Habraken/cariboulite/README.md

# CaribouLite
CaribouLite is an affordable, educational, open-source SDR evaluation platform and a HAT for the Raspberry-Pi family of boards (40-pin versions only). It is built for makers, hackers, and researchers and was designed to complement the current SDR (Software Defined Radio) eco-systems offering with a scalable, standalone dual-channel software-defined radio.

<table>
  <tr>
    <td>Open source hardware association certificate</td>
    <td>This project has been certified by OSHWA</td>
  </tr>
</table>

<table>
  <tr>
    <td>CaribouLite R2</td>
  </tr>
  <tr>
    <td>CaribouLite R2.5 SDR mounted on a RPI-Zero</td>
  </tr>
</table>

## NOTE: No Support for RPI-5
Due to the architectural changes in RPI5 - the new I/O controller called "RP1" chip, CaribouLite is not supported on RPI5. We assume that the reason is the removal of the SMI interface altogether from the external interfaces by Broadcomm's team.
So, if you intend to use CaribouLite on RPI5 please don't - it won't work. Why was the SMI interface deprecated by Broadcomm (either from its hardware or kernel SW support)? Most probably due to the same reason this interface was not documented in the first place - no interest in supporting a high-speed external interface within the 40-pin connector.

A Pi 5 transport redesign was proposed historically, but no working implementation is established here. Display/camera connectors are separate from the 40-pin GPIO header. Feasibility and scope are tracked as [DOC-10](ROADMAP.md#documentation-validation-backlog).

## Development fork status — 4 October 2026

The accepted NBFM TX/RX, mono WBFM RX and FM refactoring work is now on
`main`. Further receive modes are developed on `dev-additional-modes`, starting
with CW listening, then AM and SSB; these modes remain planned. See the
[development overview](docs/wiki/Home.md), [FM plan](docs/demodulator-architecture-research.md)
and [interface reference](docs/audio-dsp-interfaces.md).

# Getting Started & Installation

For this development checkout, also read [additional notes](ADDITIONAL-README.md),
the [documentation audit](docs/documentation-audit-2026-09-16.md), and the
[roadmap](ROADMAP.md). The historical installation recipe has not been freshly
validated on every listed Pi/OS combination.
Use the following steps to install the CaribouLite on your choice of RPI board
1. Mount the CaribouLite on a **un-powered** RPI device using the 40-pin header.
2. Power the RPI device, wait for it to finish boot sequence.
3. Clone this repository into a local directory of your choise (in this case `~/projects`)
```
mkdir ~/projects
cd ~/projects
git clone https://github.com/cariboulabs/cariboulite
cd cariboulite
```
4. Use the following setup command (**note: don't `sudo` it**):
    ```
    ./install.sh
    ```

The setup script **requires internet connection** and it follows the following automatic steps:
1. **Dependencies** installation (apt)
2. **Soapy API tools installation** (SoapySDR and SoapyRemote) - only if they are not currently present in the system. Installation from code.
3. **Internal dependencies installation**
   1. Utilities and tools
   2. IIR DSP library
   3. SMI stream device module (kernel object) blob generation
4. **Main software** and SoapyAPI compilation and installation
5. **Raspberry PI configuration** verification. The installer checks boot settings in `/boot/firmware/config.txt` when present, otherwise `/boot/config.txt`; it does not edit these boot settings. It does write module-loading, blacklist, module-option and udev files through the driver installer.

Note: the user will be requested to enter their password during the installation process.

## Installation Troubleshooting
1. **Boot interfaces:** disable the primary SPI and ARM I2C settings used by
   conflicting overlays; enable `i2c_vc` and `spi1-3cs` as described in the
   [additional notes](ADDITIONAL-README.md). The installer checks for text
   presence and can warn even about explicit `off` values (DOC-01).
2. **Kernel headers:** the current module sources are in [driver](driver/README.md).
   Rebuild for the running kernel after kernel or driver changes. Kernel
   mainline inclusion is not an implemented installation mechanism (DOC-02).
3. **Access permissions:** the current `io_utils` build uses `rpi/rpi.c` and
   `spidev/spi.c`, not the commented-out PIGPIO sources. GPIO initialization
   selects `/dev/gpiomem`; SPI uses `/dev/spidev*`, and SMI uses `/dev/smi`.
   Check the applicable device permissions and process limits; blanket claims
   that every application must run with sudo are outdated. The current broad
   udev rules and unprivileged behavior need validation (DOC-01).

To compile the API library and SoapySDR API from code please click [here](/software/libcariboulite/README.md)

# SMI Interface

Unlike many other HAT projects, CaribouLite utilizes the **SMI** (Secondary Memory Interface) used on the supported pre-Pi-5 Raspberry Pi models. This interface is not thoroughly documented by both Raspberry-Pi documentation and Broadcomm's reference manuals. An amazing work done by [Lean2](https://iosoft.blog/2020/07/16/raspberry-pi-smi/) (code in [git repo](https://github.com/jbentham/rpi)) in hacking this interface has contributed to CaribouLite's technical feasibility. A deeper overview of the interface is provided by G.J. Van Loo, 2017 `Secondary_Memory_Interface.pdf` (the referenced local PDF is missing; recovery is tracked as DOC-09). The SMI interface allows exchanging up to ~500 Mbit/s (depending on the FPGA, data-bus width, etc.) between the RPI and the HAT, and yet, the results vary between the different versions of RPI. The results further depend on the specific RPI version's DMA speeds.

The SMI interface can be accessed from the user space Linux applications as shown in [Lean2](https://iosoft.blog/2020/07/16/raspberry-pi-smi/), but Broadcomm also provided a neat minimal charachter device interface in the `/dev` directory using the `open`, `close`, `write`, `read`, and `ioctl` system calls. More on this interesting interface in the [designated readme file](software/libcariboulite/src/caribou_smi/README.md). This device driver needs to be loaded using `modprobe`.

More information on this interface can be found [here (HW side)](docs/smi/README.md) and [here (SW side)](software/libcariboulite/src/caribou_smi/README.md).

<table>
  <tr>
    <td>Top View</td>
  </tr>
  <tr>
    <td>Cariboulite /w RPI Zero, two channels occupied</td>
  </tr>
</table>

# Hardware Revisions
The board first prototyping (**Red**) revision (REV1; source assets are missing from this checkout, see DOC-09) has been produced and tested to meet our vision on the board's capabilities. This revision was used to test its RF parts, the digital parts, and to develop its firmware and software support over the RPI.

<table>
  <tr>
    <td>CaribouLite R1</td>
    <td>CaribouLite Connectors</td>
  </tr>
  <tr>
    <td>CaribouLite Rev1 - the prototype version</td>
    <td>CaribouLite Rev2.5 - Production Revision</td>
  </tr>
</table>

The second revision ([REV2](hardware/rev2)) - **White** - was then designed to further refine the design as described below:
1. Image rejection filtering improvement - U10 and U12 (HPF & LPF) - have been replaced by integrated LTCC filters by MiniCircuits with much better out-of-band rejection than the former ones.
2. Removing FPGA flash - redundant given the fact that the the RPI configures the FPGA in <1sec over SPI. Even if we have a whole library of custom made FPGA firmware files, switching between them is as simple and fast as a single linux command.
3. Board layout improvements and overlays (silkscreen) beautification (including logo).
4. A single system level 3.3V power (while the FPGA still receives 2.5V and 1.2V for its core). A linear regulator (rather than a switching DC-DC) was used to reduce conducted (power and ground) noise levels.
5. Top and bottom EMI sheilding option - the EMI/RFI shield design models are provided in the historical 3D directory (missing from this checkout; see DOC-09)
6. More detailed changes in the [schematics](hardware/rev2/schematics/CaribouLite.PDF).

In summary, in CaribouLite-Rev2.5 PCB design has been thoroughly re-thought to meet its educational needs with performance in mind. The RF path has been annotated with icons to ease the orientation in the schematics sheets, friendly silk writing was added describing system's components by their functionality rather than logical descriptors, and more.

<table>
  <tr>
    <td>Top View</td>
  </tr>
  <tr>
    <td>Top View</td>
  </tr>
  <tr>
    <td>Top and Bottom views of CaribouLite <b>Rev2.4</b> (pre-production)</td>
  </tr>
</table>

<table>
  <tr>
    <td>Top View</td>
    <td>Top View</td>
  </tr>
  <tr>
    <td>Top View</td>
  <td>Top View</td>
  </tr>
  <tr>
    <td>Top and Bottom views of CaribouLite <b>Rev2.5</b></td>
    <td>Top and Bottom views of CaribouLite <b>Rev2.5</b> with EMI/RFI shields</td>
  </tr>
</table>

# Specifications

<B>RF Channels:</B>
- Sub-1GHz: 389.5-510 MHz / 779-1020 MHz
- Wide tuning channel: 30 MHz - 6 GHz (excluding 2398.5-2400 MHz and 2483.5-2485 MHz)

<table>
  <tr>
    <td>spectra</td>
  </tr>
  <tr>
    <td style="text-align:center">Applicable spectra, S1G - sub-1GHz, WB - Wide tuning channel</td>
  </tr>
</table>
<B>Note</B>:
The gaps are defined by the design constraints of the system and may not exist in real-life hardware. Actual modem synthesizer outputs test show wider margins at room temperature than those written in the datatsheet, but, as noted by Microchip, performance may suffer.

<B>FPGA specifications:</B>
- 160 LABs / CLBs
- 1280 Logic Elements / Cells
- 65536 Total RAM bits
- 67 I/Os, Temp: -40-100 degC

<B>Applicable RPI models</B>: RPI_1(B+/A+), RPI_2B, RPI_Zero(Zero/W/WH), RPI_3(B/A+/B+), RPI_4B

Parameter                  |  Sub-1GHz                    | Wide Tuning Channel
---------------------------|------------------------------|------------------------------------------------------------------
Frequency tuner range      | 389.5-510 MHz / 779-1020 MHz | 30 MHz - 6 GHz (excluding 2398.5-2400 MHz and 2483.5-2485 MHz)
Sample rate (ADC / DAC)    | 4 MSPS                       | 4 MSPS
Analog bandwidth (Rx / Tx) | 2.5 MHz                      | 2.5 MHz
Max Transmit power         | 14 dBm                       | >10 dBm @ 30-2400 MHz, >5 dBm @ 2400-6000 MHz
Receive noise figure       | <5 dB                      | <6 dB @ 30-3500 MHz, <8 dB @ 3500-6000 MHz

<B>Note</B>:
(1) A dated, evidence-based comparison with other SDR devices remains [DOC-09](ROADMAP.md#documentation-validation-backlog).
(2) Some of the above specifications are simulated rather than tested
(3) Analog bandwidth controlled by the modem
(4) The ISM version of the board doesn't contain the wide-range of frequencies (30-6000 MHz) and contains the native capabilities of the Modem IC.

# Disclaimer
CaribouLite is a test equipment for RF systems. You are responsible for using your CaribouLite legally.

Definitions: THE SUBJECT CONTENT: all files, software, instructions, information, ideas and knowledge located in this git repository.

No Warranty: THE SUBJECT CONTENTS ARE PROVIDED "AS IS" WITHOUT ANY WARRANTY OF ANY KIND, EITHER EXPRESSED, IMPLIED, OR STATUTORY, INCLUDING, BUT NOT LIMITED TO, ANY WARRANTY THAT THE SUBJECT CONTENTS WILL CONFORM TO SPECIFICATIONS, ANY IMPLIED WARRANTIES OF MERCHANTABILITY, FITNESS FOR A PARTICULAR PURPOSE, OR FREEDOM FROM INFRINGEMENT, ANY WARRANTY THAT THE SUBJECT CONTENTS WILL BE ERROR FREE, OR ANY WARRANTY THAT DOCUMENTATION, IF PROVIDED, WILL CONFORM TO THE SUBJECT CONTENTS. FURTHER, THE REPOSITORY OWNERS AND CONTRIBUTORS DISCLAIM ALL WARRANTIES AND LIABILITIES REGARDING THIRD-PARTY SOFTWARE, IF PRESENT IN THE ORIGINAL SOFTWARE, AND DISTRIBUTE IT "AS IS."

Waiver and Indemnity: RECIPIENT AGREES TO WAIVE ANY AND ALL CLAIMS AGAINST THE REPOSITORY OWNERS AND CONTRIBUTORS, THEIR CONTRACTORS AND SUBCONTRACTORS, AS WELL AS ANY PRIOR RECIPIENT. IF RECIPIENT'S USE OF THE SUBJECT CONTENTS RESULTS IN ANY LIABILITIES, DEMANDS, DAMAGES, EXPENSES OR LOSSES ARISING FROM SUCH USE, INCLUDING ANY DAMAGES FROM PRODUCTS BASED ON, OR RESULTING FROM, RECIPIENT'S USE OF THE SUBJECT CONTENTS, RECIPIENT SHALL INDEMNIFY AND HOLD HARMLESS THE REPOSITORY OWNERS AND CONTRIBUTORS, THEIR CONTRACTORS AND SUBCONTRACTORS, AS WELL AS ANY PRIOR RECIPIENT, TO THE EXTENT PERMITTED BY LAW.

# License
<br />This work is licensed under a <a rel="license" href="http://creativecommons.org/licenses/by-sa/4.0/">Creative Commons Attribution-ShareAlike 4.0 International License</a>.
