Habraken/cariboulite/software/README.md

# CaribouLite Software
Containing all the software side for:
- `libcariboulite`: SDR APIs library - including SoapySDR
- `devicetrees`: linux device-trees overlays sources and binaries
- `utils`: various utilities
- [../examples](../examples/README.md): C, C++ and Python examples.
- `gr-caribouLite`: GNU Radio receive source module; TX integration remains on the roadmap.

# License
<br />This work is licensed under a <a rel="license" href="http://creativecommons.org/licenses/by/4.0/">Creative Commons Attribution 4.0 International License</a>.
