Habraken/cariboulite/docs/wiki/Home.md

# CaribouLite development fork

This repository builds on the original **CaribouLabs CaribouLite** hardware,
software and FPGA project. Jan's development work focuses on practical RX/TX
operation, NBFM audio, better diagnostics, and more reliable sample streaming.

**The accepted NBFM TX/RX and mono WBFM RX work is now on
[`main`](https://github.com/Habraken/cariboulite/tree/main).**
The FM refactoring steps 1–4 were accepted and merged on 4 October 2026.
New receive-mode work starts on
[`dev-additional-modes`](https://github.com/Habraken/cariboulite/tree/dev-additional-modes),
with CW listening first, followed by AM and SSB. These additional modes are
planned, not selectable features. The original `dev` branch is retained.

## What has changed?

The original CaribouLabs project provides the foundation: board support, modem
and mixer control, FPGA interfaces, SMI transport and SDR APIs. This fork extends
that foundation and addresses defects found while developing and testing it.

| Area | Accepted work on `main` |
| --- | --- |
| NBFM transmit and receive | NBFM TX/RX, mono WBFM RX, and audio pipelines in the diagnostic application, including ALSA audio routing. |
| Interactive diagnostics | NBFM menu entries and a modem monitor with RX/TX controls, register displays and streaming instrumentation. |
| FPGA TX and diagnostics | Work on TX sample sequencing, stop/reset behavior, sample-gap control and an interface-loopback diagnostic, with a tested loopback image promoted into the repository. |
| Streaming reliability | Fixes for device ownership, partial writes, timeouts, cancellation and repeated RX/TX start/stop behavior. |
| API and resource handling | Corrections to C/C++ and Soapy streaming paths, buffer handling and SPI resource cleanup. |
| Kernel compatibility | Driver builds and recorded live checks on Raspberry Pi 4 with the 64-bit kernel `6.18.39+rpt-rpi-v8`; kernel API adaptations are included in `main`. |
| Build and installation | Firmware dependency/failure handling, standalone builds without SoapySDR, and driver installation restricted to the kernel used for the build. |
| Tests and documentation | Software regressions, FPGA simulations, recorded hardware observations, a documentation audit and a development roadmap. |

These are additions and corrections made during this fork's development;
they are not a claim that every listed feature was absent from upstream.

## What works today?

Jan has reported successful **NBFM TX and RX operation** on the development
setup, including audio checks. The current diagnostic menu includes:

- **11 — NBFM TX Tone**
- **12 — NBFM RX**
- **13 — NBFM modem Self-Test**
- **14 — Monitor Modem Status**, with TX/RX and interface-loopback controls

Menu 14 uses `radio_high`, the RF24/HiF mixer path, for TX and RX, with a default
frequency of 430.100 MHz and ALSA loopback audio. Pressing T
starts/toggles TX; it does not automatically select an internal test tone.
RX supports stopped-only NBFM/mono-WBFM mode selection, 1/2/4 MS/s rate
selection and separate RX/TX frequency controls. Mode, rate and frequency
changes are blocked while streaming, and loopback guards remain in place.
NBFM noise squelch and optional carrier squelch are available; WBFM supports
carrier squelch only. Audio device defaults remain configured in code, so these are
working development tools rather than a finished configurable transceiver UI.

The separate L interface-loopback diagnostic still uses its RF24 receive path.
FPGA interface loopback has simulation coverage and recorded hardware results.
It checks part of the digital sample path; it does not demonstrate an RF QSO.
Physical Soapy RX checks are recorded, while physical Soapy TX and complete
GNU Radio TX/RX workflows still need validation.

## Kernel compatibility

As of **16 September 2026**, Jan's development system runs the 64-bit Raspberry
Pi kernel **`6.18.39+rpt-rpi-v8`**. Driver builds, installation and live RX/TX
checks on this kernel are recorded in the
[review and validation log](https://github.com/Habraken/cariboulite/blob/main/docs/code-review-2026-09-12.md).
The `main` branch includes the kernel API adaptations needed by this setup.

This identifies the kernel actually used for development and testing. Other
kernel versions still need their own validation, and the SMI module must be
rebuilt against matching headers after a kernel update.

## Where to start

Use the [`main` source tree](https://github.com/Habraken/cariboulite/tree/main)
and read the [additional installation and usage notes](https://github.com/Habraken/cariboulite/blob/main/ADDITIONAL-README.md).
They explain the development menu and audio setup, and identify historical
instructions that still need fresh installation testing.

After building, launch the application from the repository root:

```sh
./build/cariboulite_test_app 2>debug.log
```

Menu option 3 programs `firmware/top.bin` relative to that directory. Keep the
application, library, kernel driver and FPGA image consistent with the setup
being tested; selecting a Git branch does not update already installed binaries
or the image running on the FPGA.

## What is next?

The [roadmap](https://github.com/Habraken/cariboulite/blob/main/ROADMAP.md) covers:

- Clearer hardware, streaming, DSP and application interfaces, with configurable settings and broader tests.
- Squelch and menu 15: a VHF/UHF transceiver, starting with NBFM and later adding SSB, AM, CW and PSK modes.
- FPGA antenna/PTT/external-PA sequencing, Pi Zero testing, Ethernet audio/PTT and GNU Radio integration.
- Re-creating the schematics and PCB as an editable KiCad project.
- Two practical milestones: a first on-air NBFM QSO and a QO-100 QSO using SSB, CW or PSK.

These are planned milestones, not completed capabilities.

## Evidence and current limits

This overview was updated on **4 October 2026**. The eight-step audio/DSP
extraction and FM refactoring steps 1–4 are complete and physically accepted.
DSP modes own separate state, share allocation-free audio primitives, and use
a neutral `audio_demod` worker boundary with legacy API compatibility.
Software comparisons preserve exact PCM, raw taps and processing progress at
2/4 MS/s under strict and production compiler flags.

Intermittent distortion on 96.2 MHz was also observed through SDR++; much
stronger adjacent signals were reported at 95.9/96.5 MHz. A stronger station
produced clean audio, including through the Jabra speaker. The RF cause remains
unconfirmed; no refactoring regression was established.
Successful operation on Jan's setup does not establish support for every Pi,
OS, sample rate, RF path or external application. Fresh installation recipes,
RF performance and several integration paths remain under validation.

For the details behind the overview:

- [FM architecture, completed steps and acceptance](https://github.com/Habraken/cariboulite/blob/main/docs/demodulator-architecture-research.md)
- [Audio/DSP interfaces](https://github.com/Habraken/cariboulite/blob/main/docs/audio-dsp-interfaces.md)
- [Step-4 physical evidence](https://github.com/Habraken/cariboulite/blob/main/docs/baselines/20261003-fm-step4/README.md)

- [Code review and fix status](https://github.com/Habraken/cariboulite/blob/main/docs/code-review-2026-09-12.md)
- [FPGA study, hardware observations and promotion record](https://github.com/Habraken/cariboulite/blob/main/docs/fpga-gap-study-2026-09-13.md)
- [FPGA simulation checks and coverage limits](https://github.com/Habraken/cariboulite/blob/main/firmware/tests/README.md)
- [Documentation audit](https://github.com/Habraken/cariboulite/blob/main/docs/documentation-audit-2026-09-16.md)

Feedback is most useful when it includes the source revision, Pi model,
OS/kernel, FPGA image, menu/API path and steps needed to reproduce the result.
