Habraken/cariboulite/docs/README.md

# Documentation

- [Additional installation and usage notes](../ADDITIONAL-README.md)
- [Development roadmap and unresolved documentation tasks](../ROADMAP.md)
- [README validation report](documentation-audit-2026-09-16.md)
- [FM architecture and accepted refactoring steps](demodulator-architecture-research.md)
- [Menu 14 NBFM RX chain and sensitivity investigation](nbfm-rx-sensitivity-context.md)
- [Runtime profiling, stereo/RDS, DAB+ and adjustable CTCSS plan](runtime-profiling-and-decoder-plan.md)
- [NBFM complex channel filter](nbfm-channel-filter.md)
- [NBFM discriminator angle correction and CPU measurements](nbfm-discriminator-angle.md)
- [Scheduled menu 14 IQ recording](scheduled-menu14-iq-capture.md)
- [Audio/DSP interfaces](audio-dsp-interfaces.md)
- [Audio/DSP extension guide](audio-dsp-extension-guide.md)
- [Step-4 physical evidence](baselines/20261003-fm-step4/README.md)
- [Wiki overview source](wiki/Home.md)
- [SMI interface](smi/README.md)
- [EEPROM notes](flashing/README.md)
- [FPGA build and registers](../firmware/README.md)
- [Next FPGA test: LVDS Fmax before sequencer integration](lvds-fmax-next-test-2026-10-08.md)

# License
<br />This work is licensed under a <a rel="license" href="http://creativecommons.org/licenses/by-sa/4.0/">Creative Commons Attribution-ShareAlike 4.0 International License</a>.
