Habraken/cariboulite/manufacturing/rev2.8-full-eurocircuits/originals/assembly/dxf/top_emi_drawing.dxf

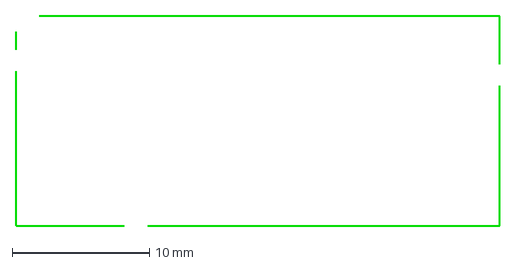
[picture p1: CAD file, 2026-09-13]
manufacturing/rev2.8-full-eurocircuits/originals/assembly/dxf/top_emi_drawing.dxf
35.2 x 15.2 mm
