Habraken/cariboulite/manufacturing/rev2.8-full-eurocircuits/originals/assembly/dxf/bottom_emi_drawing.dxf

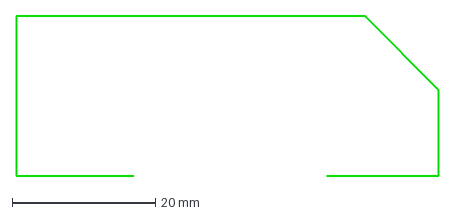
[picture p2: CAD file, 2026-09-13]
manufacturing/rev2.8-full-eurocircuits/originals/assembly/dxf/bottom_emi_drawing.dxf
59.0 x 22.2 mm
