Habraken/cariboulite/manufacturing/rev2.8-full-eurocircuits/source_manifest.md

# Source manifest

Repository commit: `d641a30b7f84c747008c77319ed4fb5d5dcd5397`

Hashes describe file contents at package generation; ISM variant files are inventoried but excluded.

| Source | Bytes | SHA-256 | Included |
|---|---:|---|---|
| `hardware/rev2/assembly/cariboulite_ad.PDF` | 429485 | `06ff852d6dadbaf617577aa71256e36cb22920a3ea1c571ff5a8441ec05f0fe2` | True |
| `hardware/rev2/assembly/dxf/bottom_emi_drawing.dxf` | 17808 | `cd04ee9178b3a7e0d64ddc9933e19037a1018f71df6390f471024ce862a8e80a` | True |
| `hardware/rev2/assembly/dxf/top_emi_drawing.dxf` | 17976 | `9215fcce824ddea93fde21a5f4bba452e5b53852239d8ca79c9adb6a8c05e9a9` | True |
| `hardware/rev2/assembly/full_bom/cariboulite_bom.xlsx` | 14724 | `2364750fdf24e97c25e7d7837e8c259b5d2b91cb83b7ce18e6b4b8066eb0e7d9` | True |
| `hardware/rev2/assembly/full_pnp/cariboulite_full_pnp.txt` | 30523 | `b10fa67b1226826b5731c93f0ef701d5a86c7cc6c1bcf2607dfc74e2f61d3e1f` | True |
| `hardware/rev2/assembly/ism_bom/cariboulite_ism_bom.xlsx` | 13326 | `b28f91d8c0919582bdae9644ad7b779ccfb9321003f2220761b5c6079d29e423` | False |
| `hardware/rev2/assembly/ism_pnp/cariboulite_ism_pnp.txt` | 17082 | `2d6e654cc9f0fbb4d88516151c0f8394cceb06e8b603fe7b4fdf8641f81086d6` | False |
| `hardware/rev2/pcb/gerber/cariboulite_r2.8.APR_LIB` | 37018 | `c65f41f1f5ff0ee96d975f81accb840b1d1dda0bbf8dcedf1998c72369a3c1a2` | True |
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
| `hardware/rev2/schematics/CaribouLite.PDF` | 2987905 | `57d33728403d0c8d10567be3fc9657d96f4d259fc30a5f506b1c498a8609c3e9` | True |
| `hardware/rev2/schematics/CaribouLite_ism.PDF` | 2990604 | `9f892cab7bac1e4079d90535e68fc2852dcef7bcdd9a2ec9649c453572b7960c` | False |
