Habraken/cariboulite/manufacturing/rev2.8-full-eurocircuits/originals/pcb/stack/cariboulite_r2.8.xls

Board Stack Report
Stack Up |  |  |  |  |  | Layer Stack
Layer | Board Layer Stack | Board Layer Stack | Board Layer Stack | Board Layer Stack | Board Layer Stack | Name | Material | Thickness | Constant
1 |  |  |  |  |  | Top Paste
2 |  |  |  |  |  | Top Overlay
3 |  |  |  |  |  | Top Solder | White | 1.00mil | 4
4 |  |  |  |  |  | Component Side | Copper | 1.38mil
5 |  |  |  |  |  | Dielectric 1 | PrePreg | 4.33mil | 4.3
6 |  |  |  |  |  | Layer 1 | Copper | 1.38mil
7 |  |  |  |  |  | Dielectric 7 | FR-4 | 47.24mil | 4.3
8 |  |  |  |  |  | Layer 2 | Copper | 1.38mil
9 |  |  |  |  |  | Dielectric 2 | PrePreg | 4.33mil | 4.3
10 |  |  |  |  |  | Solder Side | Copper | 1.38mil
11 |  |  |  |  |  | Bottom Solder | White | 1.00mil | 4
12 |  |  |  |  |  | Bottom Overlay
13 |  |  |  |  |  | Bottom Paste
 | Height : 63.42mil | Height : 63.42mil | Height : 63.42mil | Height : 63.42mil | Height : 63.42mil
