Habraken/cariboulite/manufacturing/rev2.8-full-eurocircuits/validation/drill-tools.csv

File | Tool | Copper span | Plating | Diameter inch | Diameter mm | Hits
cariboulite_r2.8.TXT | 2 | 1-4 | PTH | 0.008 | 0.2032 | 805
cariboulite_r2.8.TXT | 3 | 1-4 | PTH | 0.01811 | 0.459994 | 4
cariboulite_r2.8.TXT | 4 | 1-4 | PTH | 0.02362 | 0.599948 | 2
cariboulite_r2.8.TXT | 5 | 1-4 | PTH | 0.0315 | 0.8001 | 2
cariboulite_r2.8.TXT | 6 | 1-4 | PTH | 0.03543 | 0.899922 | 40
cariboulite_r2.8.TXT | 7 | 1-4 | NPTH | 0.10827 | 2.750058 | 3
cariboulite_r2.8.TX1 | 1 | 1-2 | PTH | 0.004 | 0.1016 | 661
cariboulite_r2.8.TX2 | 1 | 3-4 | PTH | 0.004 | 0.1016 | 736
