Habraken/cariboulite/manufacturing/rev2.8-full-eurocircuits/originals/schematics/CaribouLite.PDF

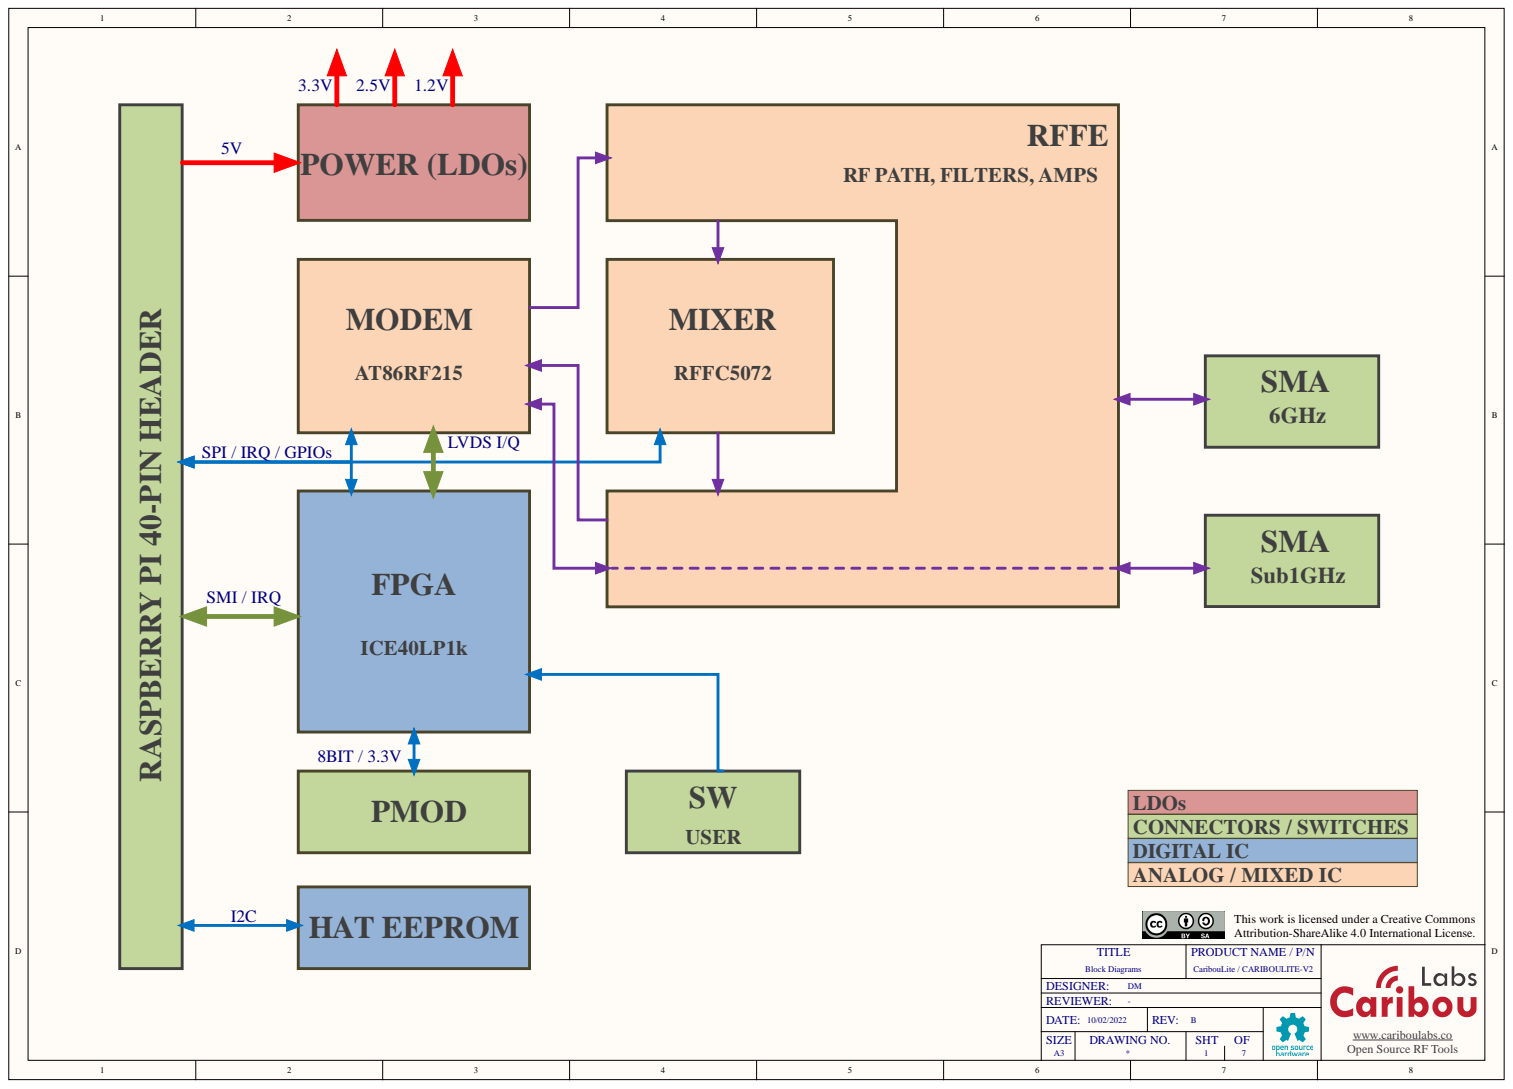
[picture p3: page 1]
SIZE; DRAWING NO.; CaribouLite / CARIBOULITE-V2; TITLE; PRODUCT NAME / P/N; Block Diagrams; POWER (LDOs); HAT EEPROM; 8BIT / 3.3V; LVDS I/Q; SMI / IRQ

RF PATH, FILTERS, AMPS

SPI / IRQ / GPIOs

LDOs
CONNECTORS / SWITCHES
DIGITAL IC
ANALOG / MIXED IC

This work is licensed under a Creative Commons
Attribution-ShareAlike 4.0 International License.

www.cariboulabs.co
Open Source RF Tools

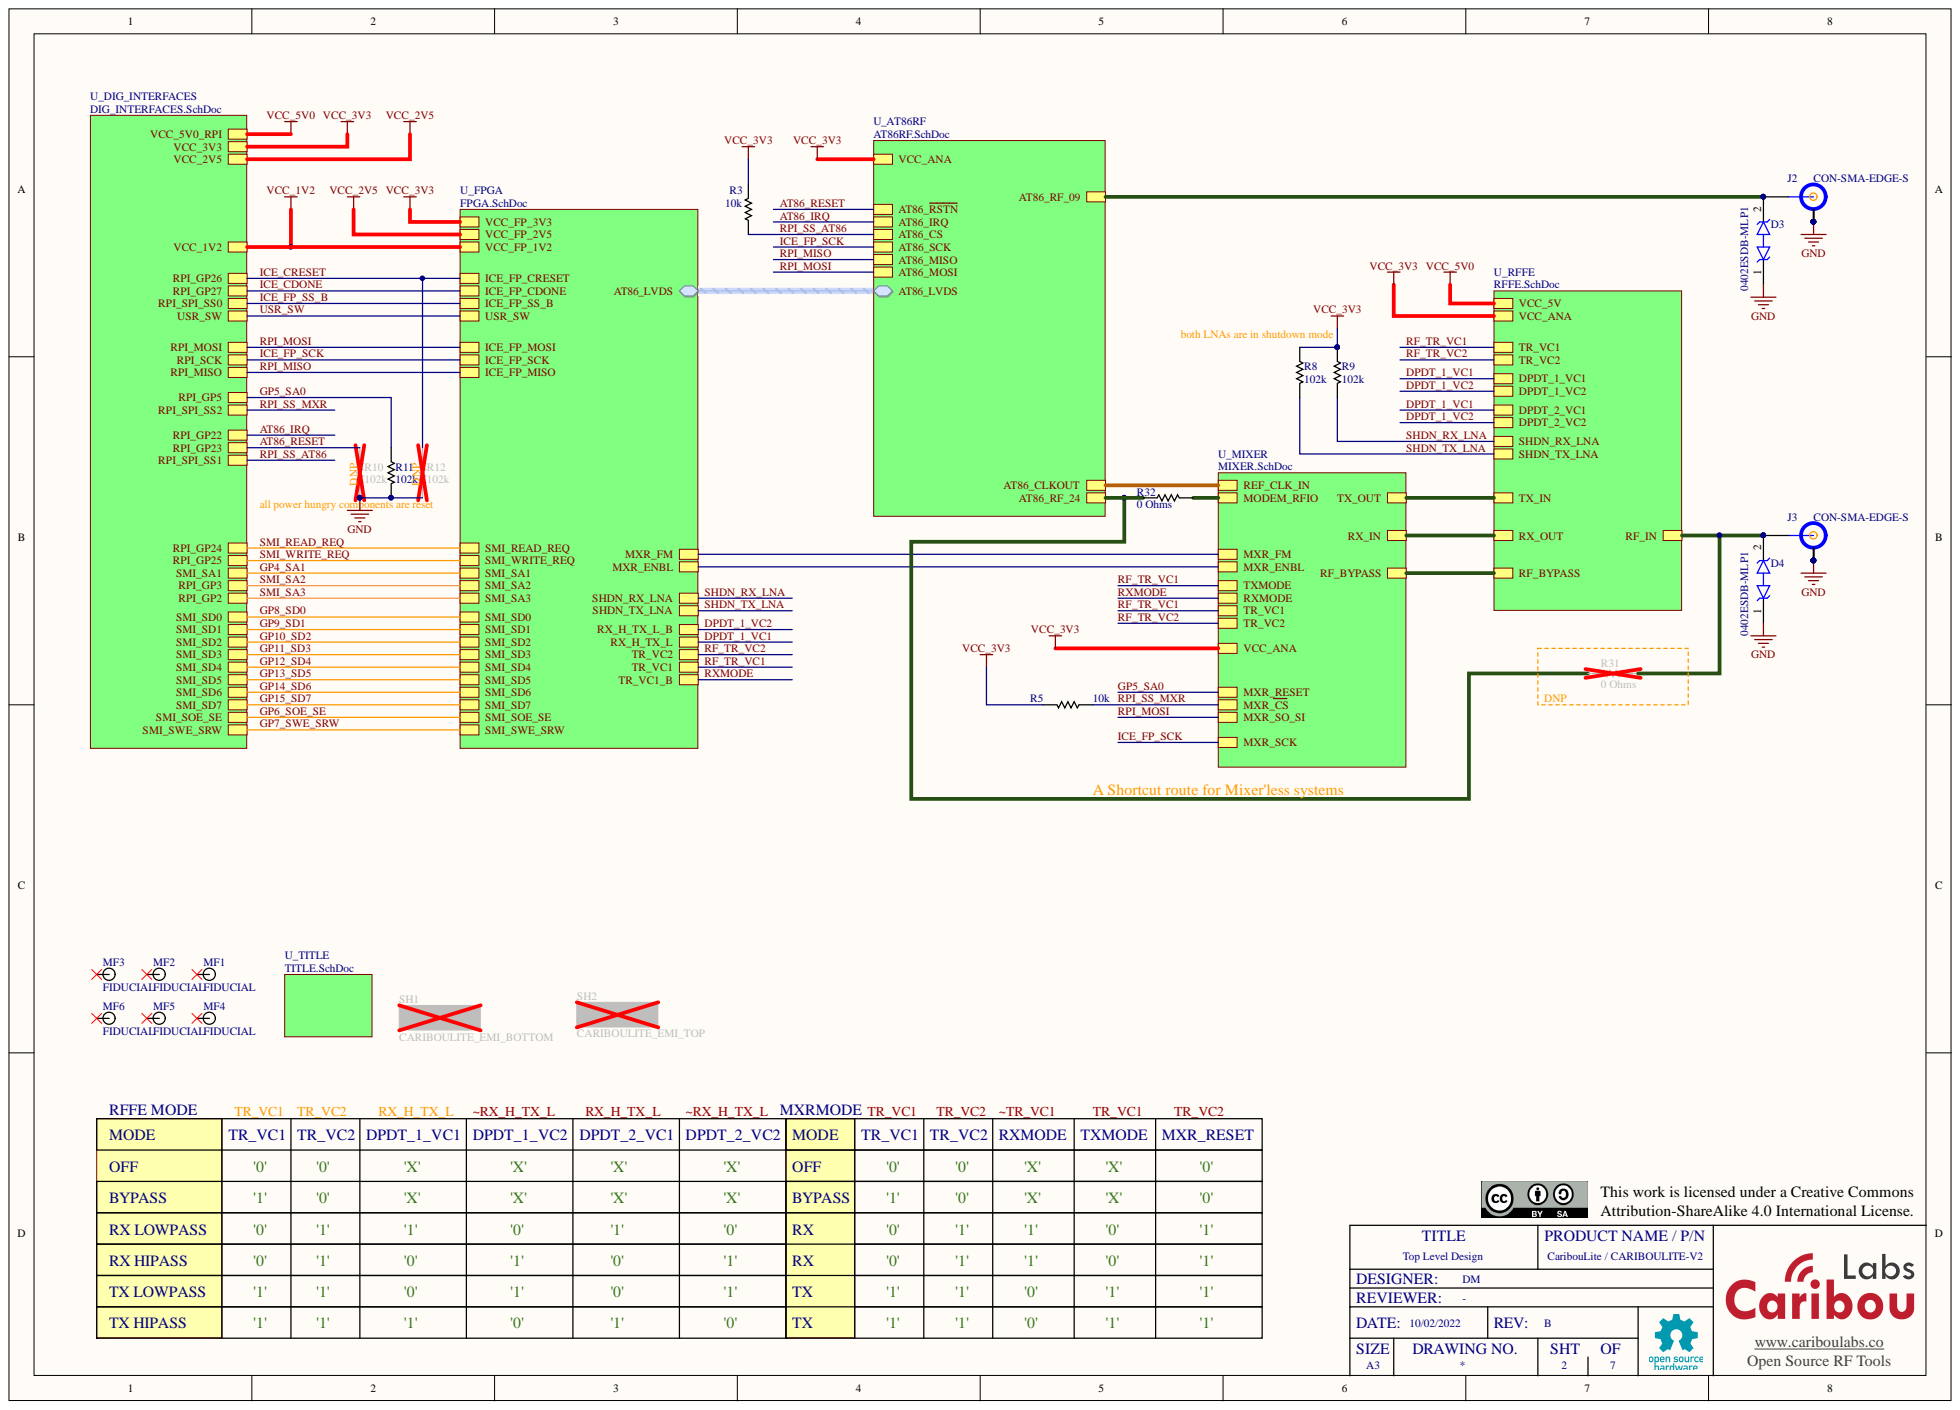
[picture p4: page 2]

ICE_CDONE
ICE_FP_SS_B
USR_SW

both LNAs are in shutdown mode

RPI_MISO

all power hungry components are reset

A Shortcut route for Mixer'less systems

MODE | TR_VC1 | TR_VC2 | DPDT_1_VC1 | DPDT_1_VC2 | DPDT_2_VC1 | DPDT_2_VC2 | MODE | TR_VC1 | TR_VC2 | RXMODE | TXMODE | MXR_RESET

OFF | '0' | '0' | 'X' | 'X' | 'X' | 'X' | OFF | '0' | '0' | 'X' | 'X' | '0'

This work is licensed under a Creative Commons
Attribution-ShareAlike 4.0 International License.

BYPASS | '1' | '0' | 'X' | 'X' | 'X' | 'X' | BYPASS | '1' | '0' | 'X' | 'X' | '0'

RX LOWPASS | '0' | '1' | '1' | '0' | '1' | '0' | RX | '0' | '1' | '1' | '0' | '1'

RX HIPASS | '0' | '1' | '0' | '1' | '0' | '1' | RX | '0' | '1' | '1' | '0' | '1'

TX LOWPASS | '1' | '1' | '0' | '1' | '0' | '1' | TX | '1' | '1' | '0' | '1' | '1'

TX HIPASS | '1' | '1' | '1' | '0' | '1' | '0' | TX | '1' | '1' | '0' | '1' | '1'

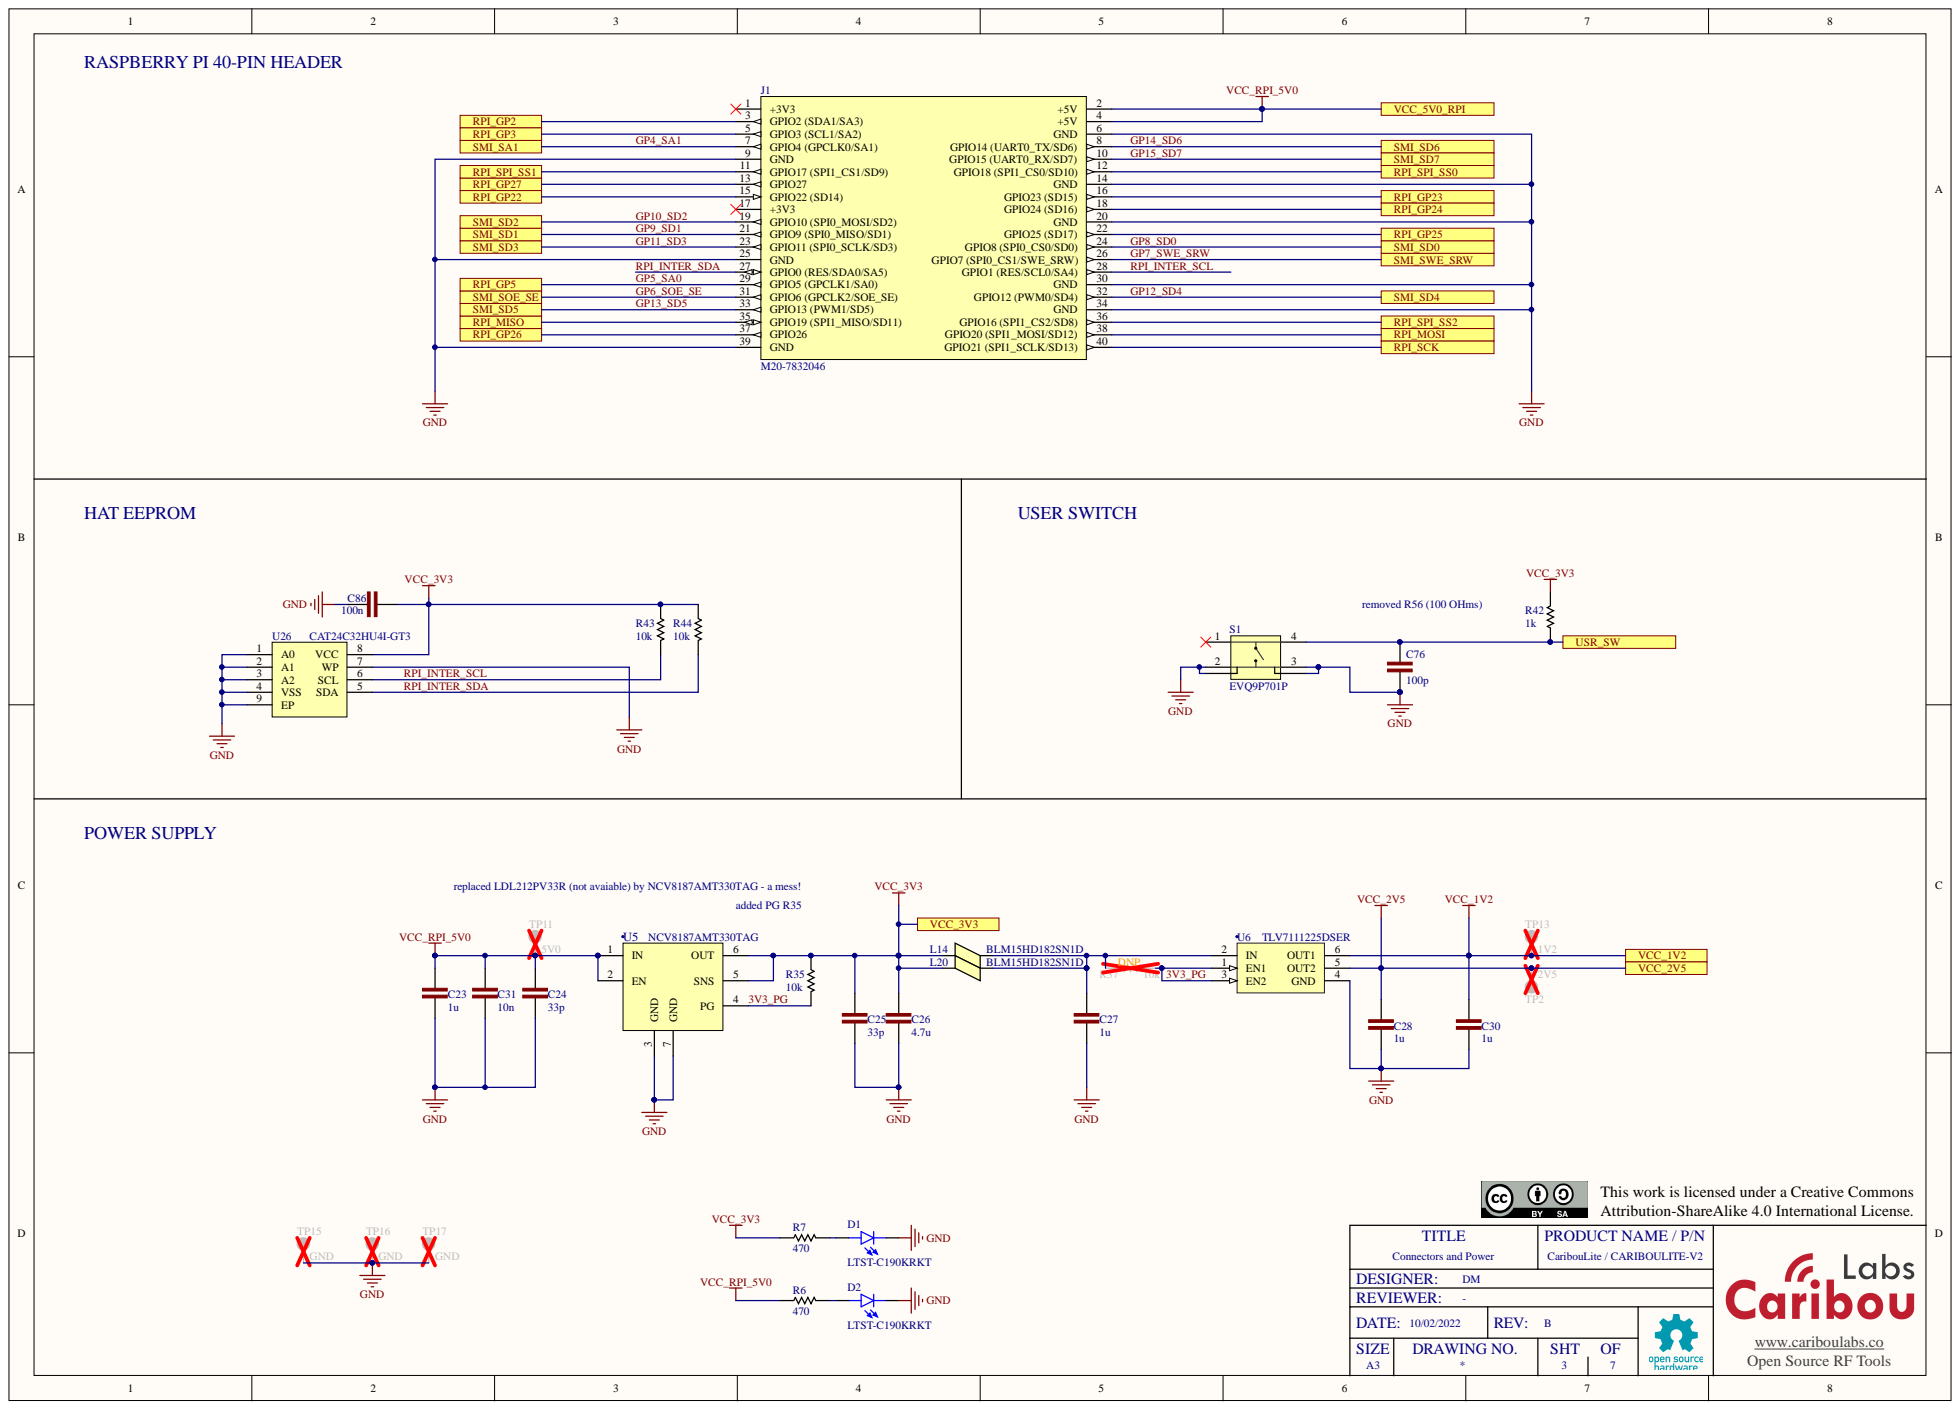
[picture p5: page 3]

RASPBERRY PI 40-PIN HEADER

VSS 4 | RPI_INTER_SDA
EP 9

replaced LDL212PV33R (not avaiable) by NCV8187AMT330TAG - a mess!

This work is licensed under a Creative Commons
Attribution-ShareAlike 4.0 International License.

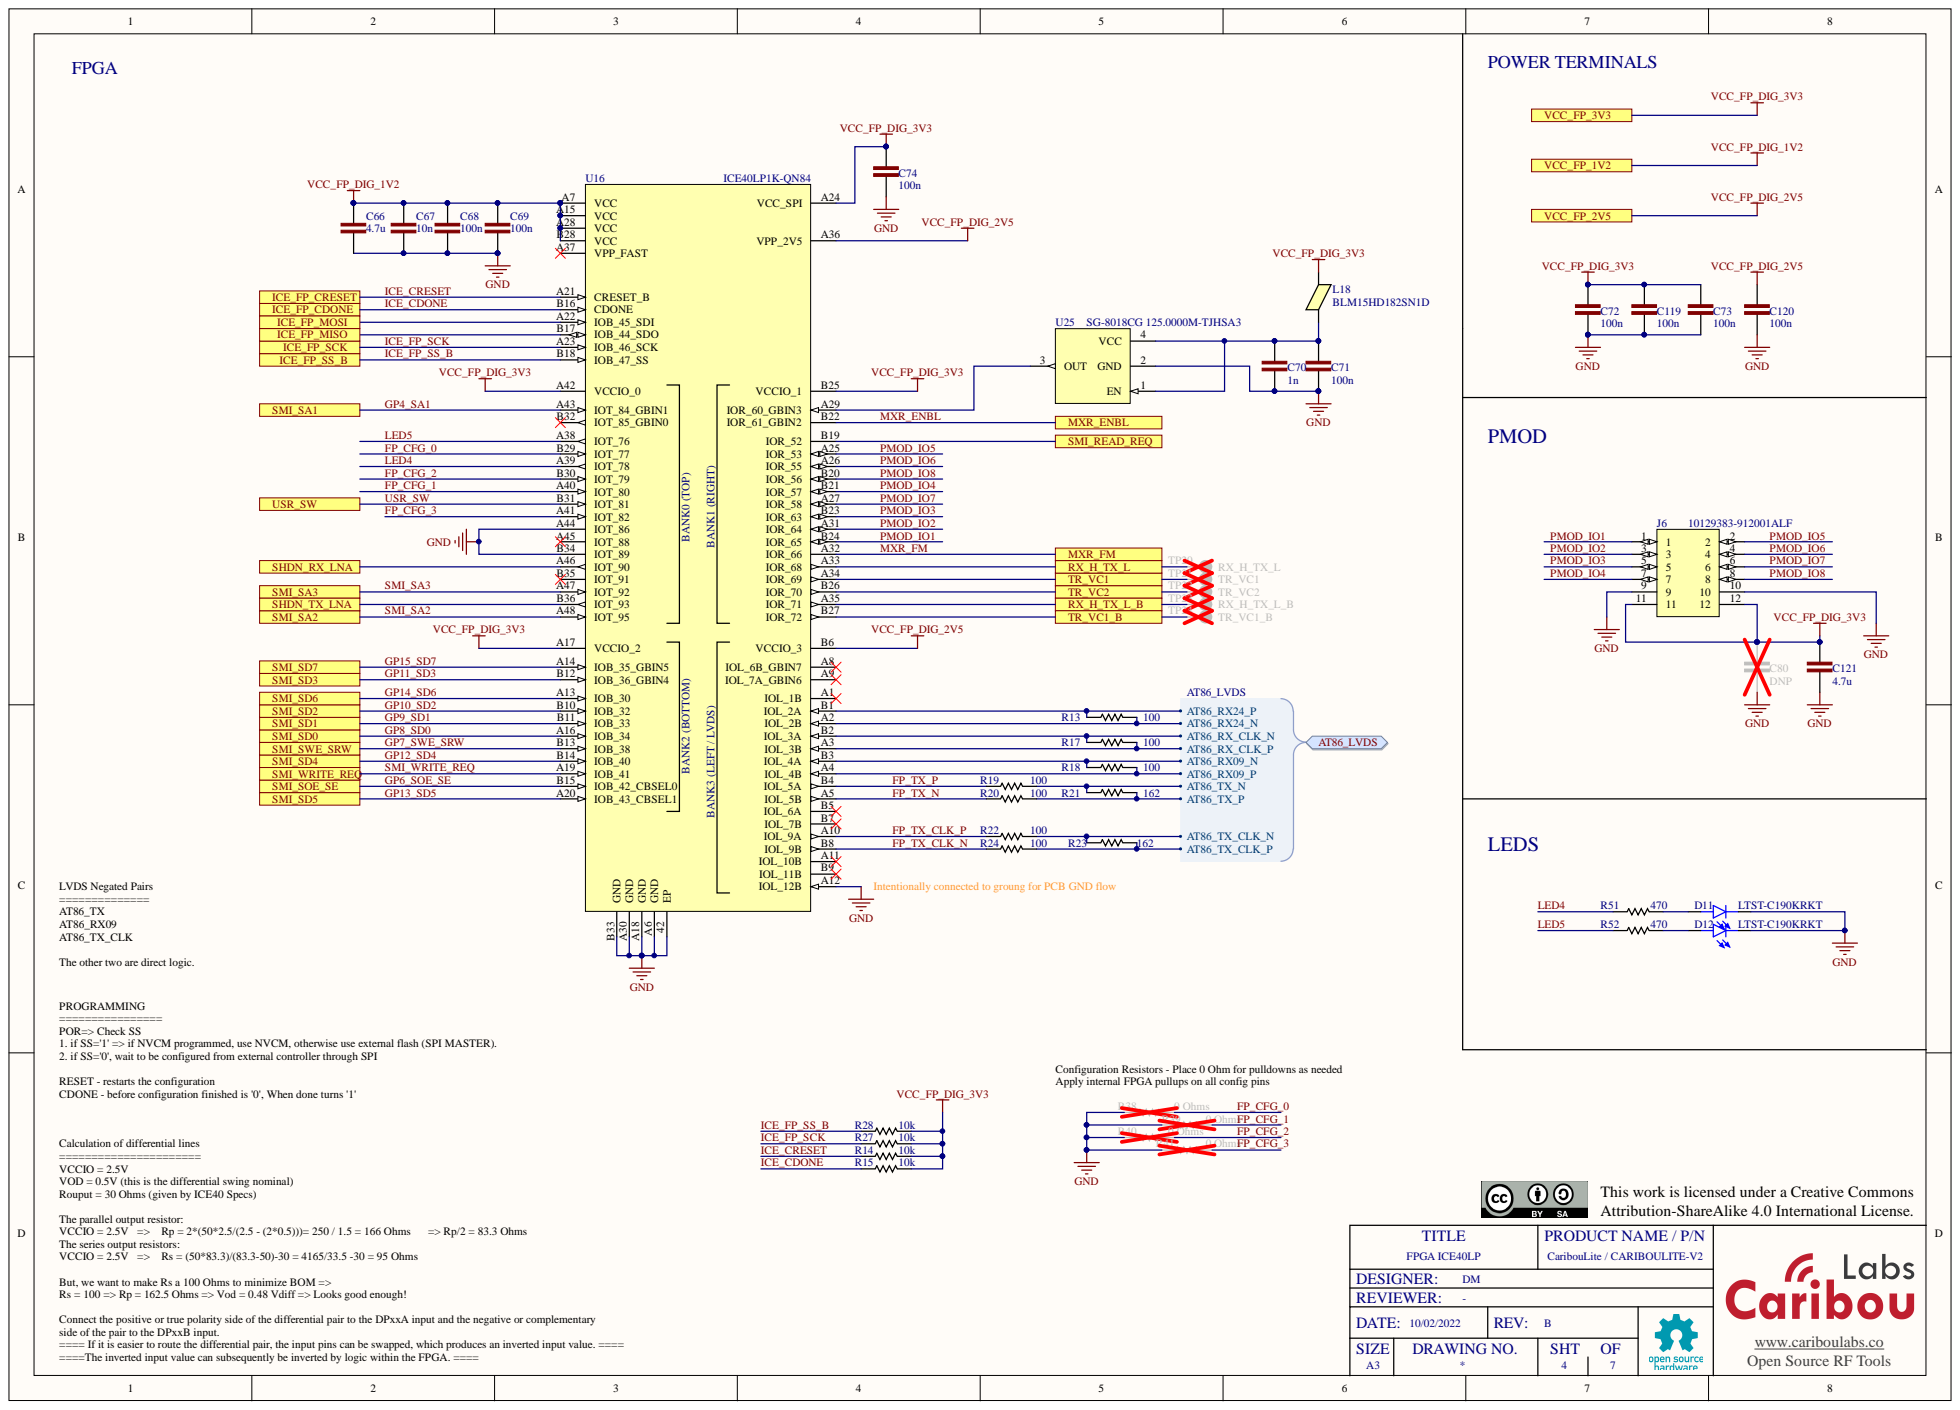
[picture p6: page 4]

Intentionally connected to groung for PCB GND flow

The other two are direct logic.

PROGRAMMING
POR=> Check SS
1. if SS='1' => if NVCM programmed, use NVCM, otherwise use external flash (SPI MASTER).
2. if SS='0', wait to be configured from external controller through SPI

Configuration Resistors - Place 0 Ohm for pulldowns as needed
Apply internal FPGA pullups on all config pins

RESET - restarts the configuration
CDONE - before configuration finished is '0', When done turns '1'

Calculation of differential lines
VCCIO = 2.5V
VOD = 0.5V (this is the differential swing nominal)
Rouput = 30 Ohms (given by ICE40 Specs)

This work is licensed under a Creative Commons
Attribution-ShareAlike 4.0 International License.

The parallel output resistor:
The series output resistors:
VCCIO = 2.5V => Rs = (50*83.3)/(83.3-50)-30 = 4165/33.5 -30 = 95 Ohms

But, we want to make Rs a 100 Ohms to minimize BOM =>
Rs = 100 => Rp = 162.5 Ohms => Vod = 0.48 Vdiff => Looks good enough!

Connect the positive or true polarity side of the differential pair to the DPxxA input and the negative or complementary
side of the pair to the DPxxB input.
==== If it is easier to route the differential pair, the input pins can be swapped, which produces an inverted input value. ====
====The inverted input value can subsequently be inverted by logic within the FPGA. ====

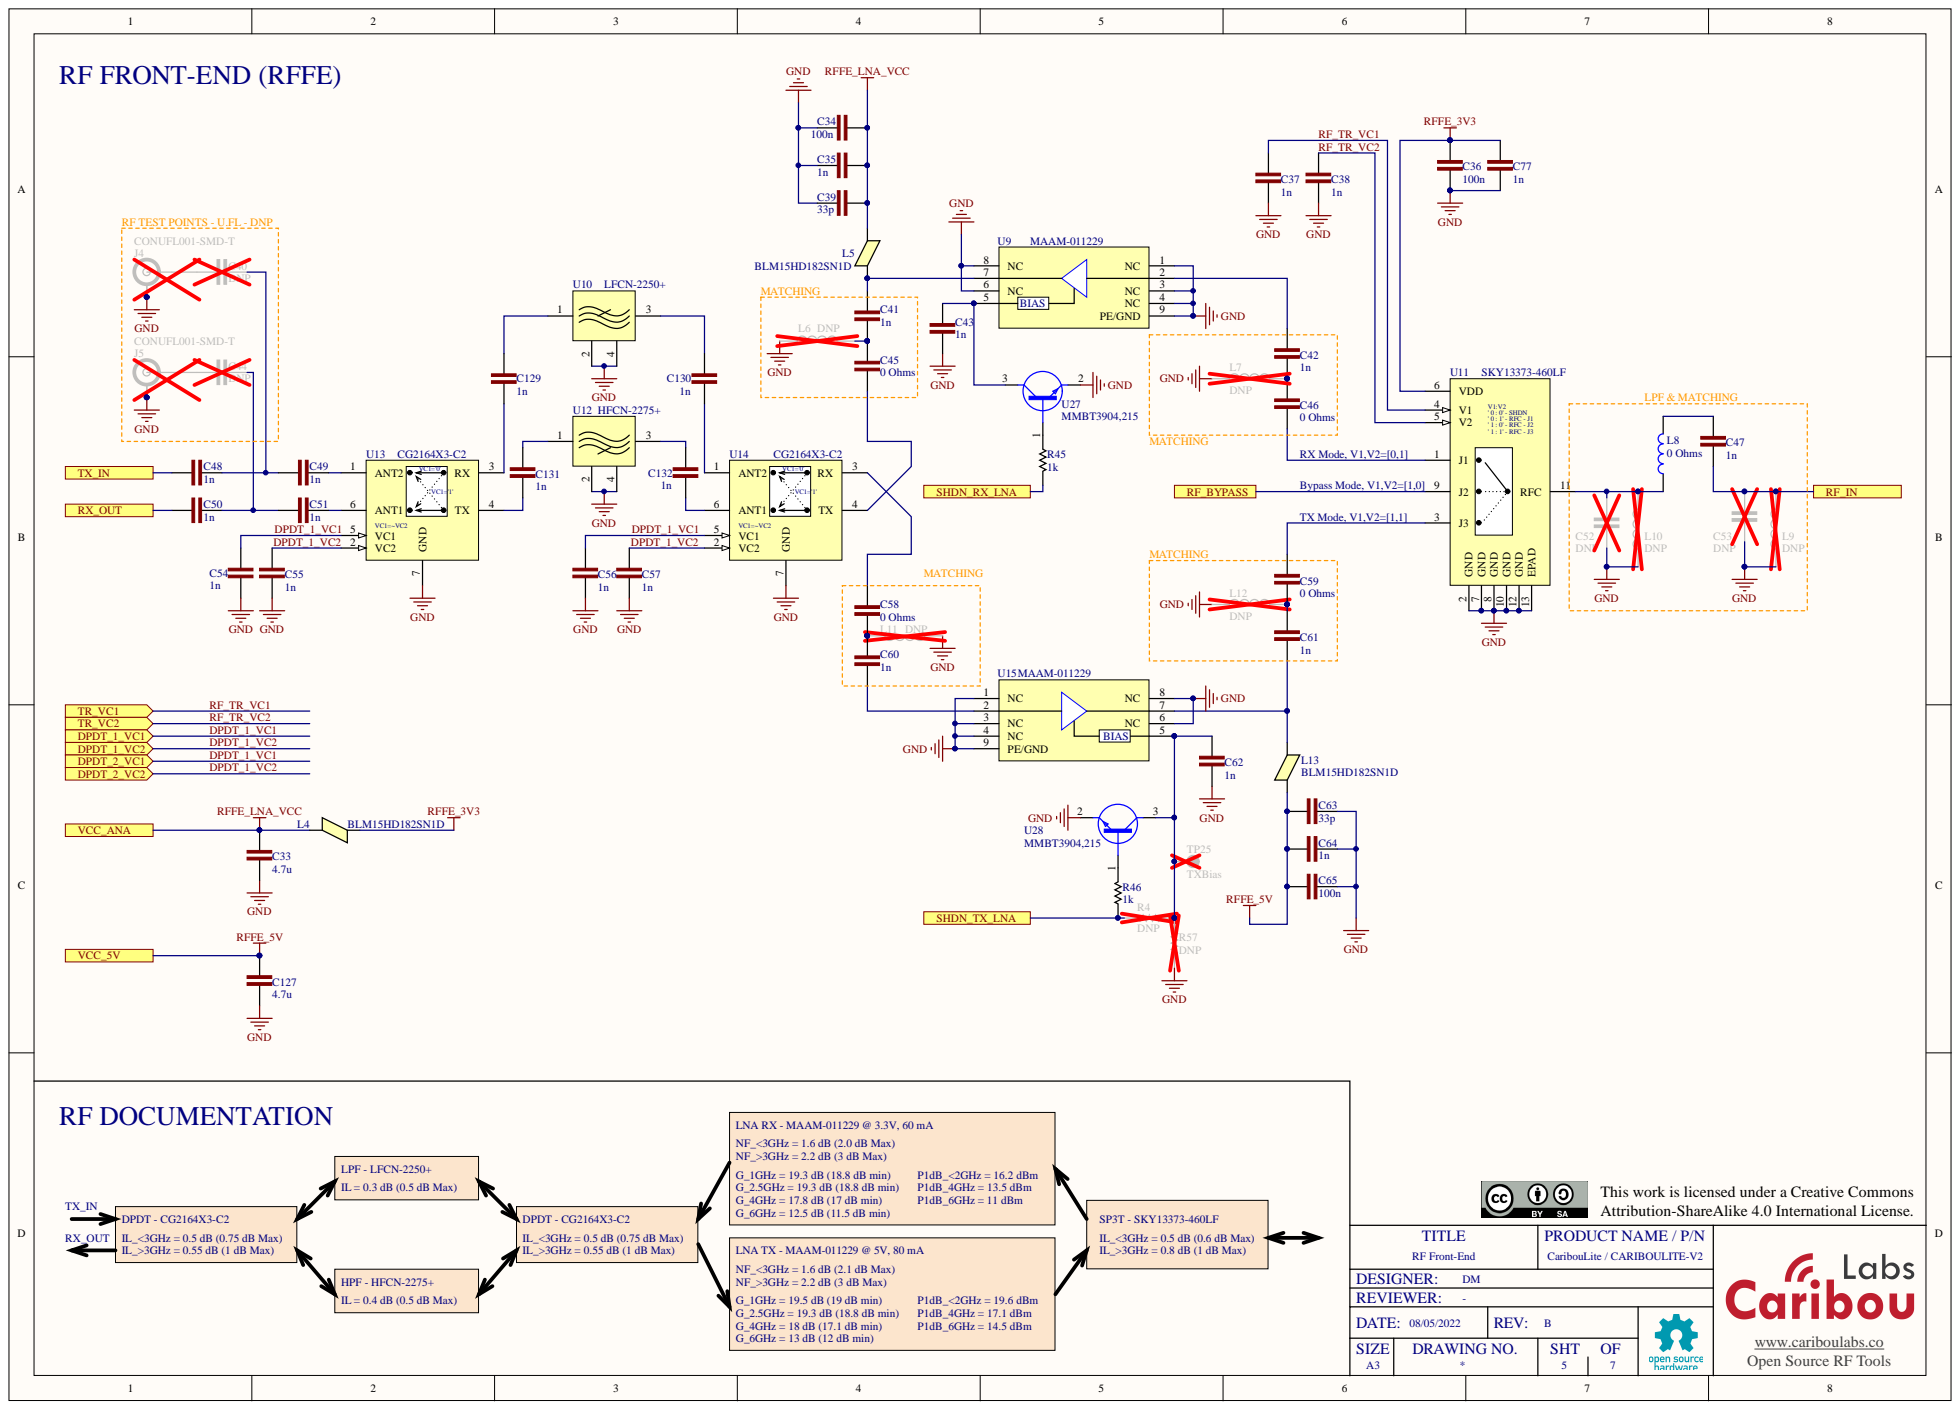
[picture p7: page 5]

RF FRONT-END (RFFE)

RF TEST POINTS - U.FL - DNP
CONUFL001-SMD-T

NC 3

LNA RX - MAAM-011229 @ 3.3V, 60 mA
NF_<3GHz = 1.6 dB (2.0 dB Max)
NF_>3GHz = 2.2 dB (3 dB Max)
G_1GHz = 19.3 dB (18.8 dB min)
G_2.5GHz = 19.3 dB (18.8 dB min)
G_4GHz = 17.8 dB (17 dB min)
G_6GHz = 12.5 dB (11.5 dB min)

LPF - LFCN-2250+
IL = 0.3 dB (0.5 dB Max)

This work is licensed under a Creative Commons
Attribution-ShareAlike 4.0 International License.

LNA TX - MAAM-011229 @ 5V, 80 mA
NF_<3GHz = 1.6 dB (2.1 dB Max)
G_1GHz = 19.5 dB (19 dB min)
G_4GHz = 18 dB (17.1 dB min)
G_6GHz = 13 dB (12 dB min)

HPF - HFCN-2275+
IL = 0.4 dB (0.5 dB Max)

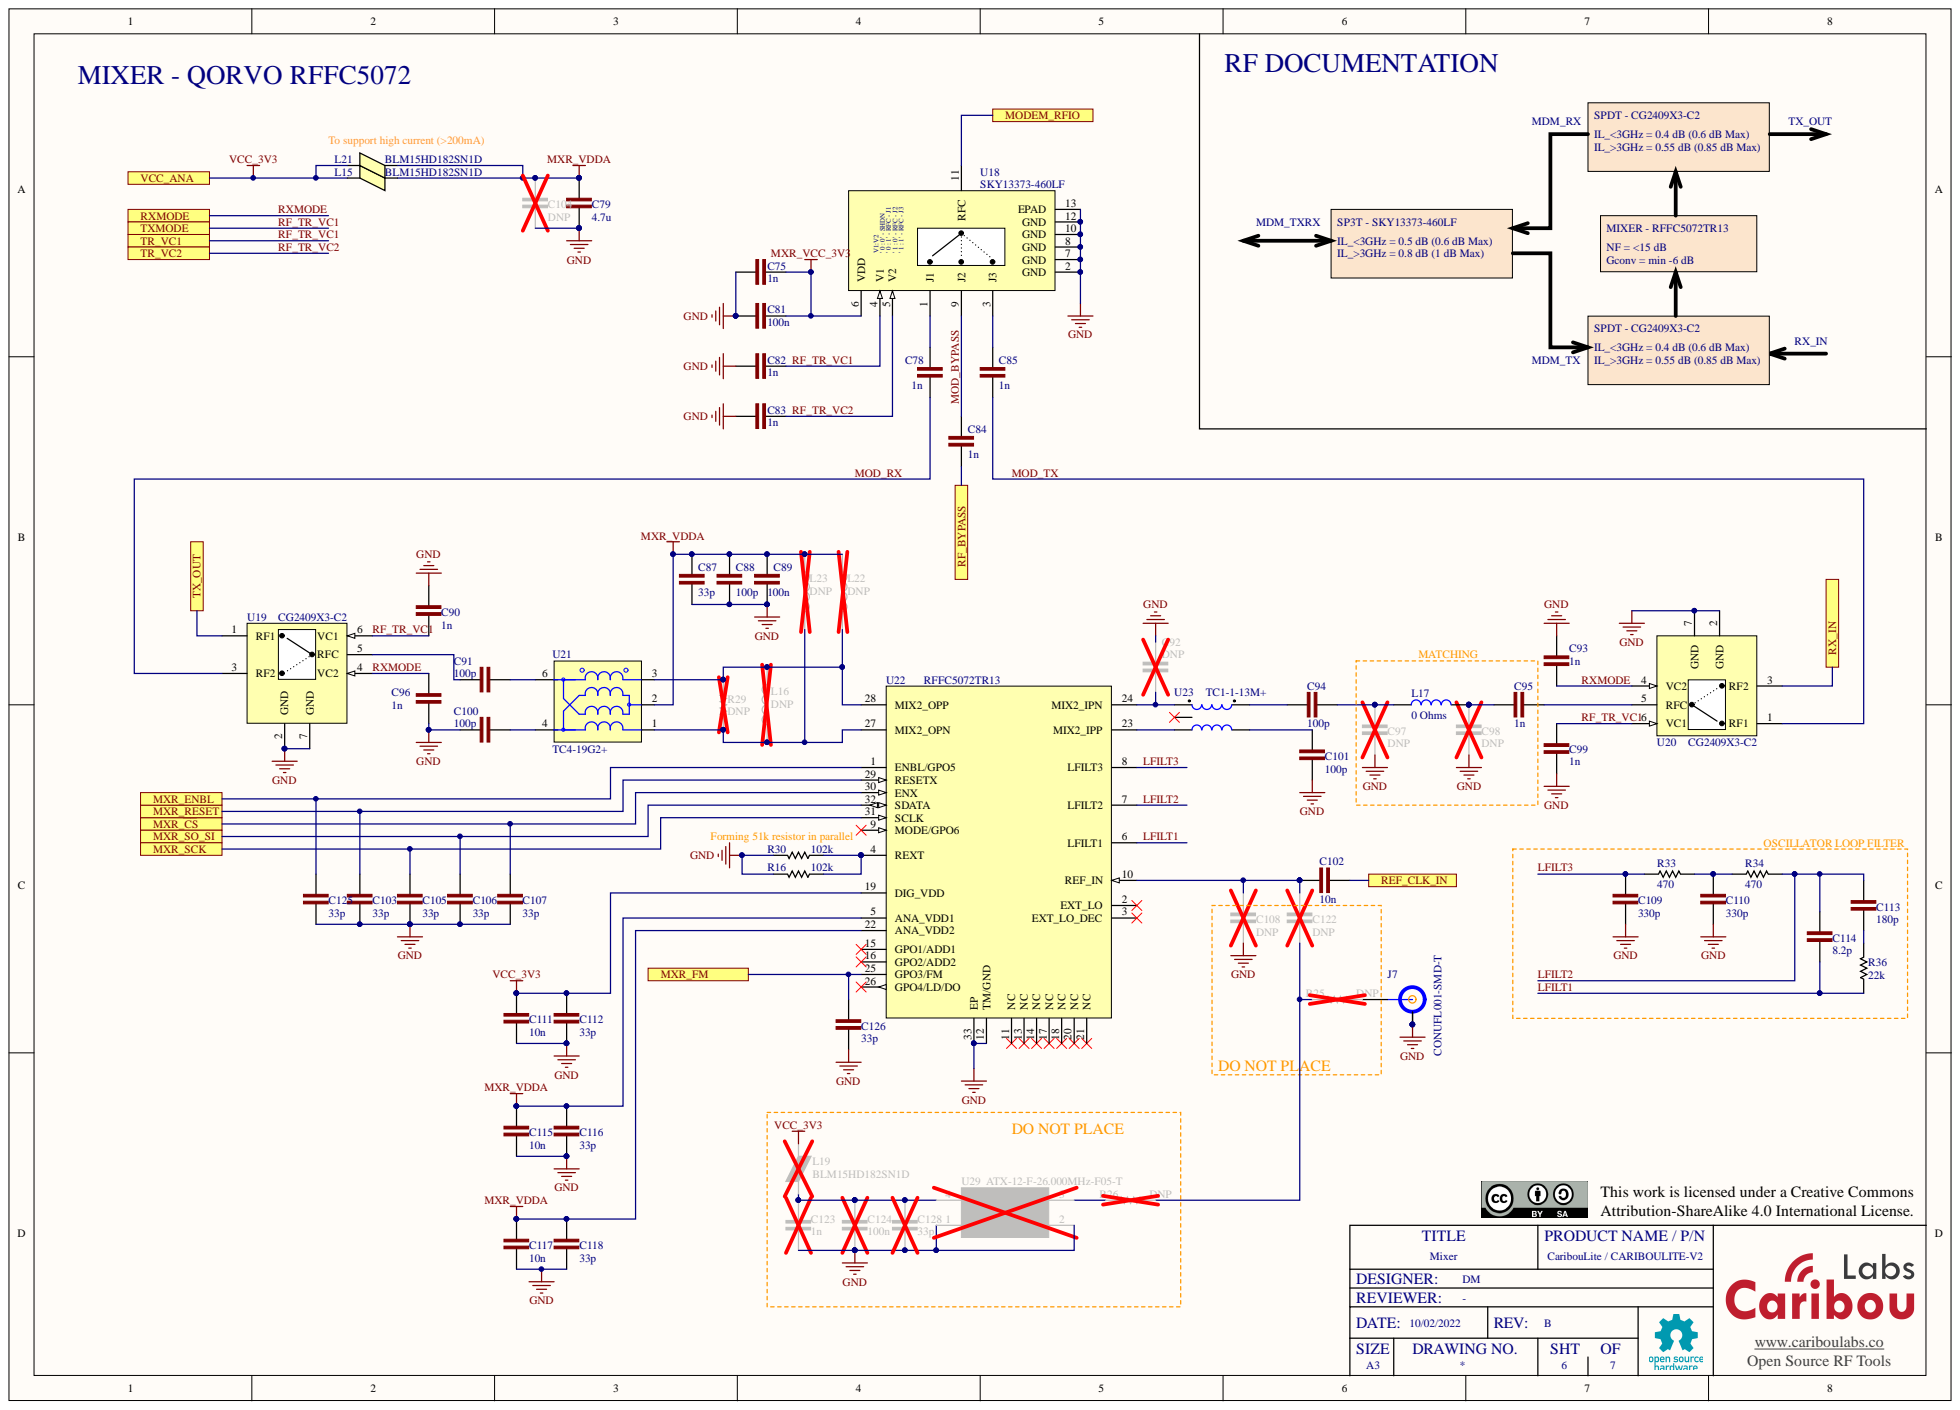
[picture p8: page 6]

RF DOCUMENTATION MIXER - QORVO RFFC5072

To support high current (>200mA)

RXMODE

GND | RESETX 29

ENX 30

MXR_ENBL | | SCLK 31 SDATA 32
MXR_RESET
MXR_CS | | | MODE/GPO6 9
MXR_SO_SI | | | | REXT 4

Forming 51k resistor in parallel

C107 33p | ANA_VDD1 5

ANA_VDD2 22

This work is licensed under a Creative Commons
Attribution-ShareAlike 4.0 International License.

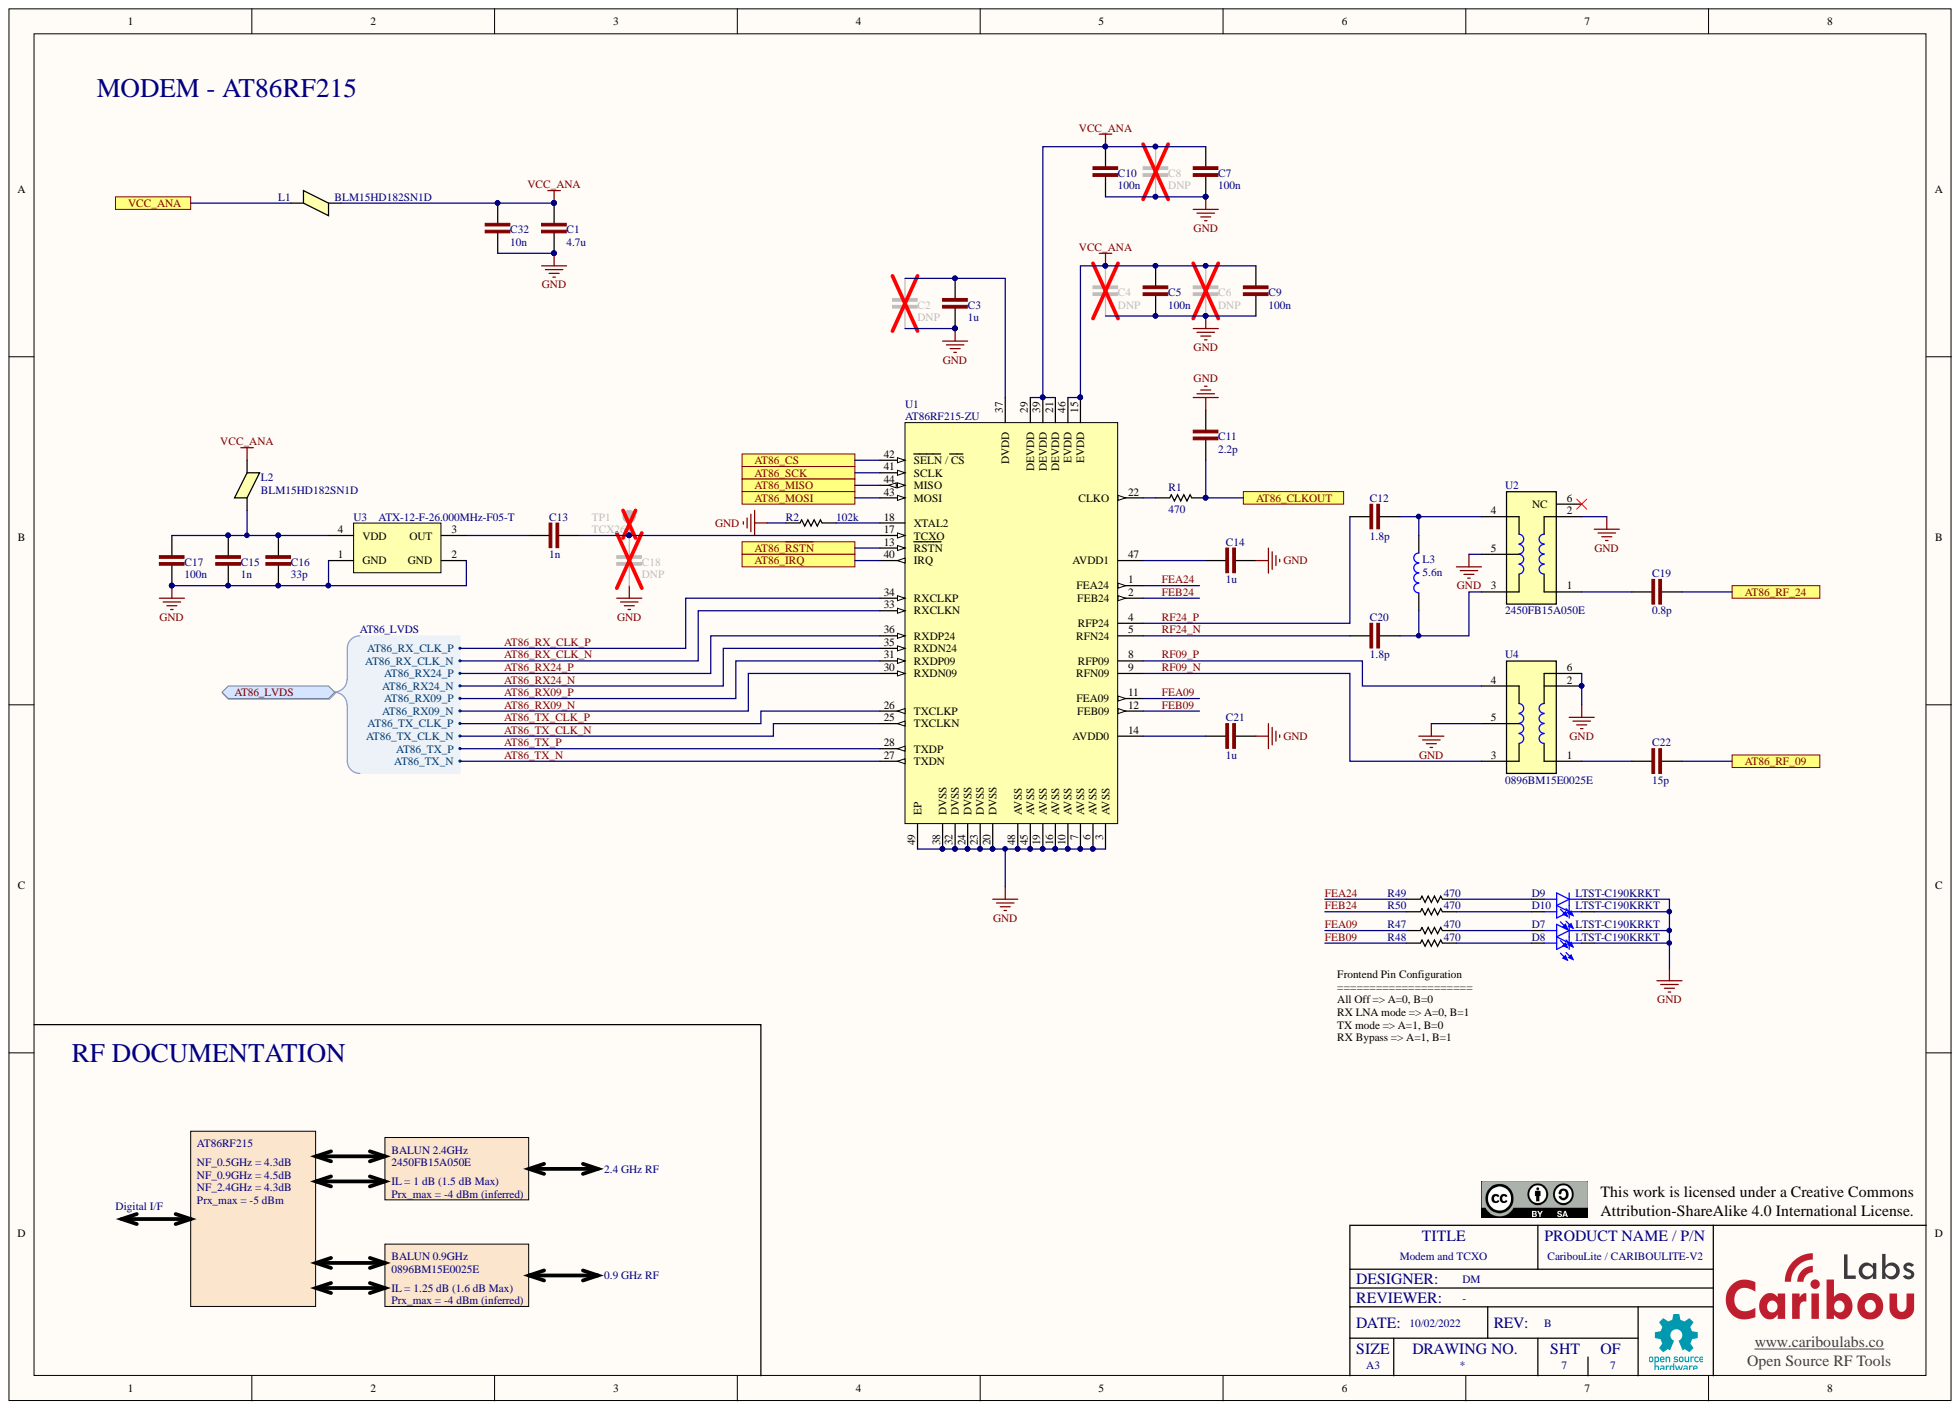
[picture p9: page 7]

RXCLKN 33

RXDP24 36

AT86_RX_CLK_P | RXDN24 35
AT86_RX_CLK_N | RXDP09 31

IL = 1 dB (1.5 dB Max)

This work is licensed under a Creative Commons
Attribution-ShareAlike 4.0 International License.
