Habraken/cariboulite/software/libcariboulite/src/nbfm_mod.c

#include "nbfm_mod.h"
#include <stdlib.h>
#include <errno.h>
#include <math.h>
#include "math_compat.h"

typedef struct { double a0,a1; float x1; } preemph_t;
static void preemph_init(preemph_t* p,double fs,double tau){
    if(tau<=0){p->a0=1;p->a1=0;p->x1=0;return;}
    double T=1.0/fs, alpha=tau/(tau+T);
    p->a0=1.0+alpha; p->a1=-alpha; p->x1=0;
}
static inline float preemph_run(preemph_t* p,float x){
    float y=(float)p->a0*x+(float)p->a1*p->x1; p->x1=x; return y;
}

struct nbfm_mod {
    double fs_a, fs_rf, f_dev, R, a_to_rf, k;
    float  out_scale; int lin;
    double phase, dphi_cur, dphi_next, interp_step, interp_acc;
    preemph_t pe;
    float* afifo; size_t cap, head, tail, cnt;
    
    //new
    double lm_phase;
    int use_lin;
};

static int valid_config(const nbfm_cfg_t* c)
{
    return c->audio_fs == 48000 &&
        (c->rf_fs == 1000000 || c->rf_fs == 2000000 || c->rf_fs == 4000000) &&
        isfinite(c->f_dev_hz) && c->f_dev_hz >= 0 && c->f_dev_hz <= 24000 &&
        isfinite(c->preemph_tau_s) && c->preemph_tau_s >= 0 &&
        isfinite(c->out_scale) && c->out_scale >= 0 && c->out_scale <= 32767 &&
        (c->linear_interp == 0 || c->linear_interp == 1);
}
nbfm_mod_t* nbfm_create(const nbfm_cfg_t* config)
{
    const nbfm_cfg_t defaults = {48000, 4000000, NBFM_DEFAULT_DEVIATION_HZ, 0, 12000, 1};
    const nbfm_cfg_t* c = config ? config : &defaults;
    if (!valid_config(c)) { errno = EINVAL; return NULL; }
    nbfm_mod_t* m = calloc(1, sizeof(*m));
    if (!m) { errno = ENOMEM; return NULL; }
    m->fs_a=c->audio_fs; m->fs_rf=c->rf_fs;
    m->f_dev=c->f_dev_hz; m->out_scale=c->out_scale;
    m->lin=c->linear_interp; m->R=m->fs_rf/m->fs_a; m->a_to_rf=1.0/m->R;
    m->k=2.0*M_PI*m->f_dev/m->fs_rf;
    preemph_init(&m->pe,m->fs_a,c->preemph_tau_s);
    m->interp_acc=1.0; m->cap=4096;
    m->afifo=calloc(m->cap,sizeof(float));
    if (!m->afifo) { free(m); errno = ENOMEM; return NULL; }
    m->lm_phase=0; m->use_lin=m->lin;
    return m;
}
void nbfm_reset(nbfm_mod_t* m)
{
    if (!m) return;
    m->head=m->tail=m->cnt=0;
    m->phase=m->dphi_cur=m->dphi_next=m->lm_phase=0;
    m->interp_step=0; m->interp_acc=1;
    m->pe.x1=0;
}
size_t nbfm_buffered_audio(const nbfm_mod_t* m) { return m ? m->cnt : 0; }
static int valid_audio(const float* audio, size_t frames)
{
    if (!audio && frames) return 0;
    for (size_t n=0; n<frames; ++n) if (!isfinite(audio[n])) return 0;
    return 1;
}

void nbfm_destroy(nbfm_mod_t* m) { 
    if(!m)return; 
    free(m->afifo); 
    free(m); 
}

static size_t enqueue_audio(nbfm_mod_t* m,const float* a,size_t N) {
    size_t p=0; 
    for(size_t n=0;n<N;n++) {
        if(m->cnt == m->cap) break;
        m->afifo[m->tail] = a[n]; 
        m->tail=(m->tail+1)%m->cap; 
        m->cnt++; p++; 
    } 
    return p;
}
size_t nbfm_push_audio(nbfm_mod_t* m, const float* audio, size_t frames)
{
    if (!m || !valid_audio(audio, frames)) { errno = EINVAL; return 0; }
    return enqueue_audio(m, audio, frames);
}
static int fetch_audio(nbfm_mod_t* m) {
    if (m->cnt == 0) return 0;

    float x = m->afifo[m->head];
    m->head = (m->head+1)%m->cap; 
    m->cnt--; 
    
    if (x>1) x=1; 
    else if (x<-1) x=-1;
    
    float xp=preemph_run(&m->pe,x); 
    m->dphi_next=m->k*(double)xp; 
    return 1;
}

static size_t generate_iq(nbfm_mod_t* m, iq16_t* dst, size_t N, size_t* held)
{
    const double L = m->fs_rf;
    const double M = m->fs_a;
    size_t out = 0;

    while (out < N) {
        // Advance audio time using the configured input/output rates.
        m->lm_phase += M;
        if (m->lm_phase >= L) {
            m->lm_phase -= L;

            // Move current -> next and fetch next audio-derived freq
            m->dphi_cur = m->dphi_next;
            if (!fetch_audio(m)) {
                // Preserve frequency hold, but report the underrun to explicit callers.
                if (held) ++*held;
                m->dphi_next = m->dphi_cur;
            }
        }

        // Linear interpolation of frequency between audio ticks (optional)
        double frac = m->use_lin ? (double)m->lm_phase / (double)L : 0.0;
        double dphi = m->dphi_cur + (m->dphi_next - m->dphi_cur) * frac;

        // Integrate to phase with robust wrap
        m->phase += dphi;
        if (m->phase >  M_PI) m->phase -= 2.0 * M_PI;
        if (m->phase < -M_PI) m->phase += 2.0 * M_PI;

        float ci = (float)cos(m->phase);
        float sq = (float)sin(m->phase);
        int32_t I = (int32_t)lrintf(ci * m->out_scale);
        int32_t Q = (int32_t)lrintf(sq * m->out_scale);
        if (I >  32767) I =  32767; else if (I < -32768) I = -32768;
        if (Q >  32767) Q =  32767; else if (Q < -32768) Q = -32768;

        dst[out].i = (int16_t)I;
        dst[out].q = (int16_t)Q;
        out++;
    }
    return out;
}
size_t nbfm_pull_iq(nbfm_mod_t* m, iq16_t* dst, size_t frames)
{
    if (!m || (!dst && frames)) { errno = EINVAL; return 0; }
    return generate_iq(m, dst, frames, NULL);
}
nbfm_result_t nbfm_process(nbfm_mod_t* m, const audio_f32_t* audio, size_t frames,
                           iq16_t* output, size_t capacity)
{
    nbfm_result_t result = {0};
    if (!m || (!output && capacity) || !valid_audio(audio, frames)) {
        result.error = -EINVAL;
        return result;
    }
    result.consumed = enqueue_audio(m, audio, frames);
    result.produced = generate_iq(m, output, capacity, &result.held_audio);
    return result;
}
