Habraken/cariboulite/software/libcariboulite/src/nbfm_defaults.h

#pragma once

// Shared nominal NBFM deviation for application TX defaults, RX normalization
// and the matching noise-squelch scale.
#ifndef NBFM_DEFAULT_DEVIATION_HZ
#define NBFM_DEFAULT_DEVIATION_HZ 2500.0f
#endif
