Habraken/cariboulite/(commit log)

2025-04-28 Update smi_stream_dev.c
    Minor corrections
    [smi_stream_dev.c]
2025-05-01 Added a detailed installation description
    Added a markdown file with a detailed description of how the CaribouLite can be install on a Pi0 or a Pi4, running the latest and up-to-date Raspberry Pi 64 bit OS: Bookworm (lite).
2025-10-02 Modified smi driver, to include a first attempt to complete the tx path.
2025-10-04 Switched to buildin test tone for A/B testing.
2025-10-04 Fixed TX tone menu option.
    [app_menu.c]
2025-10-04 small UI print fix for frequency value.
    [app_menu.c]
2025-10-04 Minor print format fix.
    [app_menu.c]
2026-03-20 swapped LEDs
2026-09-13 Add code review and Rev 2.8 manufacturing quotation package
    [02-full-bom.csv, bom-audit.csv, bottom_emi_drawing.dxf, cariboulite_bom.xlsx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]
2026-09-13 Resolve U25 oscillator selection
    [02-full-bom.csv, bom-audit.csv]
2026-09-13 Resolve J7 population decision
    [02-full-bom.csv, bom-audit.csv]
2026-09-13 Prevent concurrent clients from disrupting CaribouLite hardware
    Enforce exclusive SMI opens and claim the device before GPIO setup. Retain ownership through cleanup and explicitly stop streaming before closing the transport.
    Add regression tests and document the software baseline, successful two-session TX validation, and driver installation.
    [smi_stream_dev.c]
2026-09-13 Fix RX worker lifecycle and route option 12 audio through loopback
    Track created workers, unwind partial RX initialization, and clean up FIFO mutexes and reader metadata on cancellation. Handle failed reader starts and avoid joining uncreated or already joined threads.
    Add lifecycle and cancellation regression tests and document successful live RX and USB audio validation.
    [app_menu.c]
2026-09-13 Bound C++ synchronous reads to allocated buffer capacity
    Record the internal read capacity and cap requests before calling the C reader. Document partial-read behavior and add guard-page regression tests for integer and float samples and metadata.
2026-09-13 Serialize SMI stream transitions with a sleepable mutex
    Hold the transition mutex across state checks, helper shutdown, DMA stop/start, and helper startup. Remove the unlocked ioctl shortcut and stop TX helpers before DMA teardown.
    Add transition contention and failure recovery tests; document live RX/TX validation and permanent driver installation.
    [smi_stream_dev.c]
2026-09-13 Bound TX tone waits and complete shutdown on worker failure
    Apply a shared deadline to tone injection, abort waits when workers stop, and serialize injection cancellation. Shut TX down on failed start-tone injection and skip draining when the tail tone fails.
    Add deadline and failure-path regression tests and document successful live checks of options 11, 12, and 14 TX/RX.
    [app_menu.c]
2026-09-13 Preserve partial TX write progress across retries
    Account for current-chunk progress on timeout and error exits, retain partial-sample byte offsets, and document retry semantics. Add exact-byte regression tests and record successful live TX validation.
2026-09-13 Remove padding from public TX writes
    Delegate public writes to the streaming writer so short requests preserve the sample sequence and report only accepted samples. Document retry semantics and extend exact-byte regression coverage.
2026-09-13 Unwind partial TX initialization and guard monitor startup
    Track created TX workers and clean up all owned resources after initialization failures. Enter the monitor only after both pipelines initialize successfully, releasing TX if RX initialization fails.
    Extend lifecycle failure-injection tests and record successful live TX/RX validation.
    [app_menu.c]
2026-09-13 Fix FPGA SPI success status handling
2026-09-13 Support selectable TX sample rates with tested FPGA gap firmware
2026-09-13 Add selectable TX/RX sample rates to modem monitor
2026-09-14 Serialize SPI lifecycle and safely close shared resources
2026-09-14 Fix Soapy stream deadlines, activation state and error reporting
    [cariboulite_radio.h]
2026-09-15 Restrict driver installation to the build kernel
2026-09-19 Rename NBFM modulator for multiple sample rates and remove unused mini app
2026-09-19 Add physical baseline runner and record validated HiF audio tests
    [events.csv]
2026-09-19 Rename ALSA source adapter and record successful physical retest
    [events.csv]
2026-09-19 Introduce audio source interface and record successful H1 test
    [events.csv]
2026-09-19 Consolidate tone sources and record successful H2 tests
    [events.csv]
2026-09-19 Fix kernel header selection for driver rebuilds
2026-09-19 Extract ALSA playback sink and record passed H3 checks
    [events.csv]
2026-09-19 Separate NBFM demodulator DSP and record passed H4 checks
    [events.csv]
2026-09-19 Define explicit NBFM modulator contract and record passed H5 checks
    [events.csv]
2026-09-19 Extract TX/RX pipelines and record passed H6 checks
    [events.csv]
2026-09-19 Add RX noise and carrier squelch with accepted RSSI thresholds
    [app_menu.c, demod_worker.c, demod_worker.h, nbfm_demod.c, nbfm_demod.h, pipeline_transport.h, rx_pipeline.c, rx_pipeline.h]
2026-09-27 Removed TX power setting ambiguity.
2026-09-27 updated tx power level
2026-10-03 freeze current FM behaviour
2026-10-10 Fix TX-to-RX stream handoff
    Keep normal SMI stream transitions in the pipeline lifecycle so delayed TX writer cleanup cannot stop reception. Serialize TX writes with shutdown and recheck TX state after polling.
    Add threaded regression coverage for delayed FIFO dequeue, delayed poll completion, and in-flight writes during the handoff at 1, 2 and 4 MS/s.
    [tx_pipeline.c]
2026-10-10 Switched back to RF24
2026-10-10 The incorrect `fast_atan2f_small` approximation has been replaced by full `atan2f`, with a zero-product guard.
    [nbfm_demod_dsp.c]
